piotr-binkowski/kintex-pcie-board/kintex-pcie.pdf

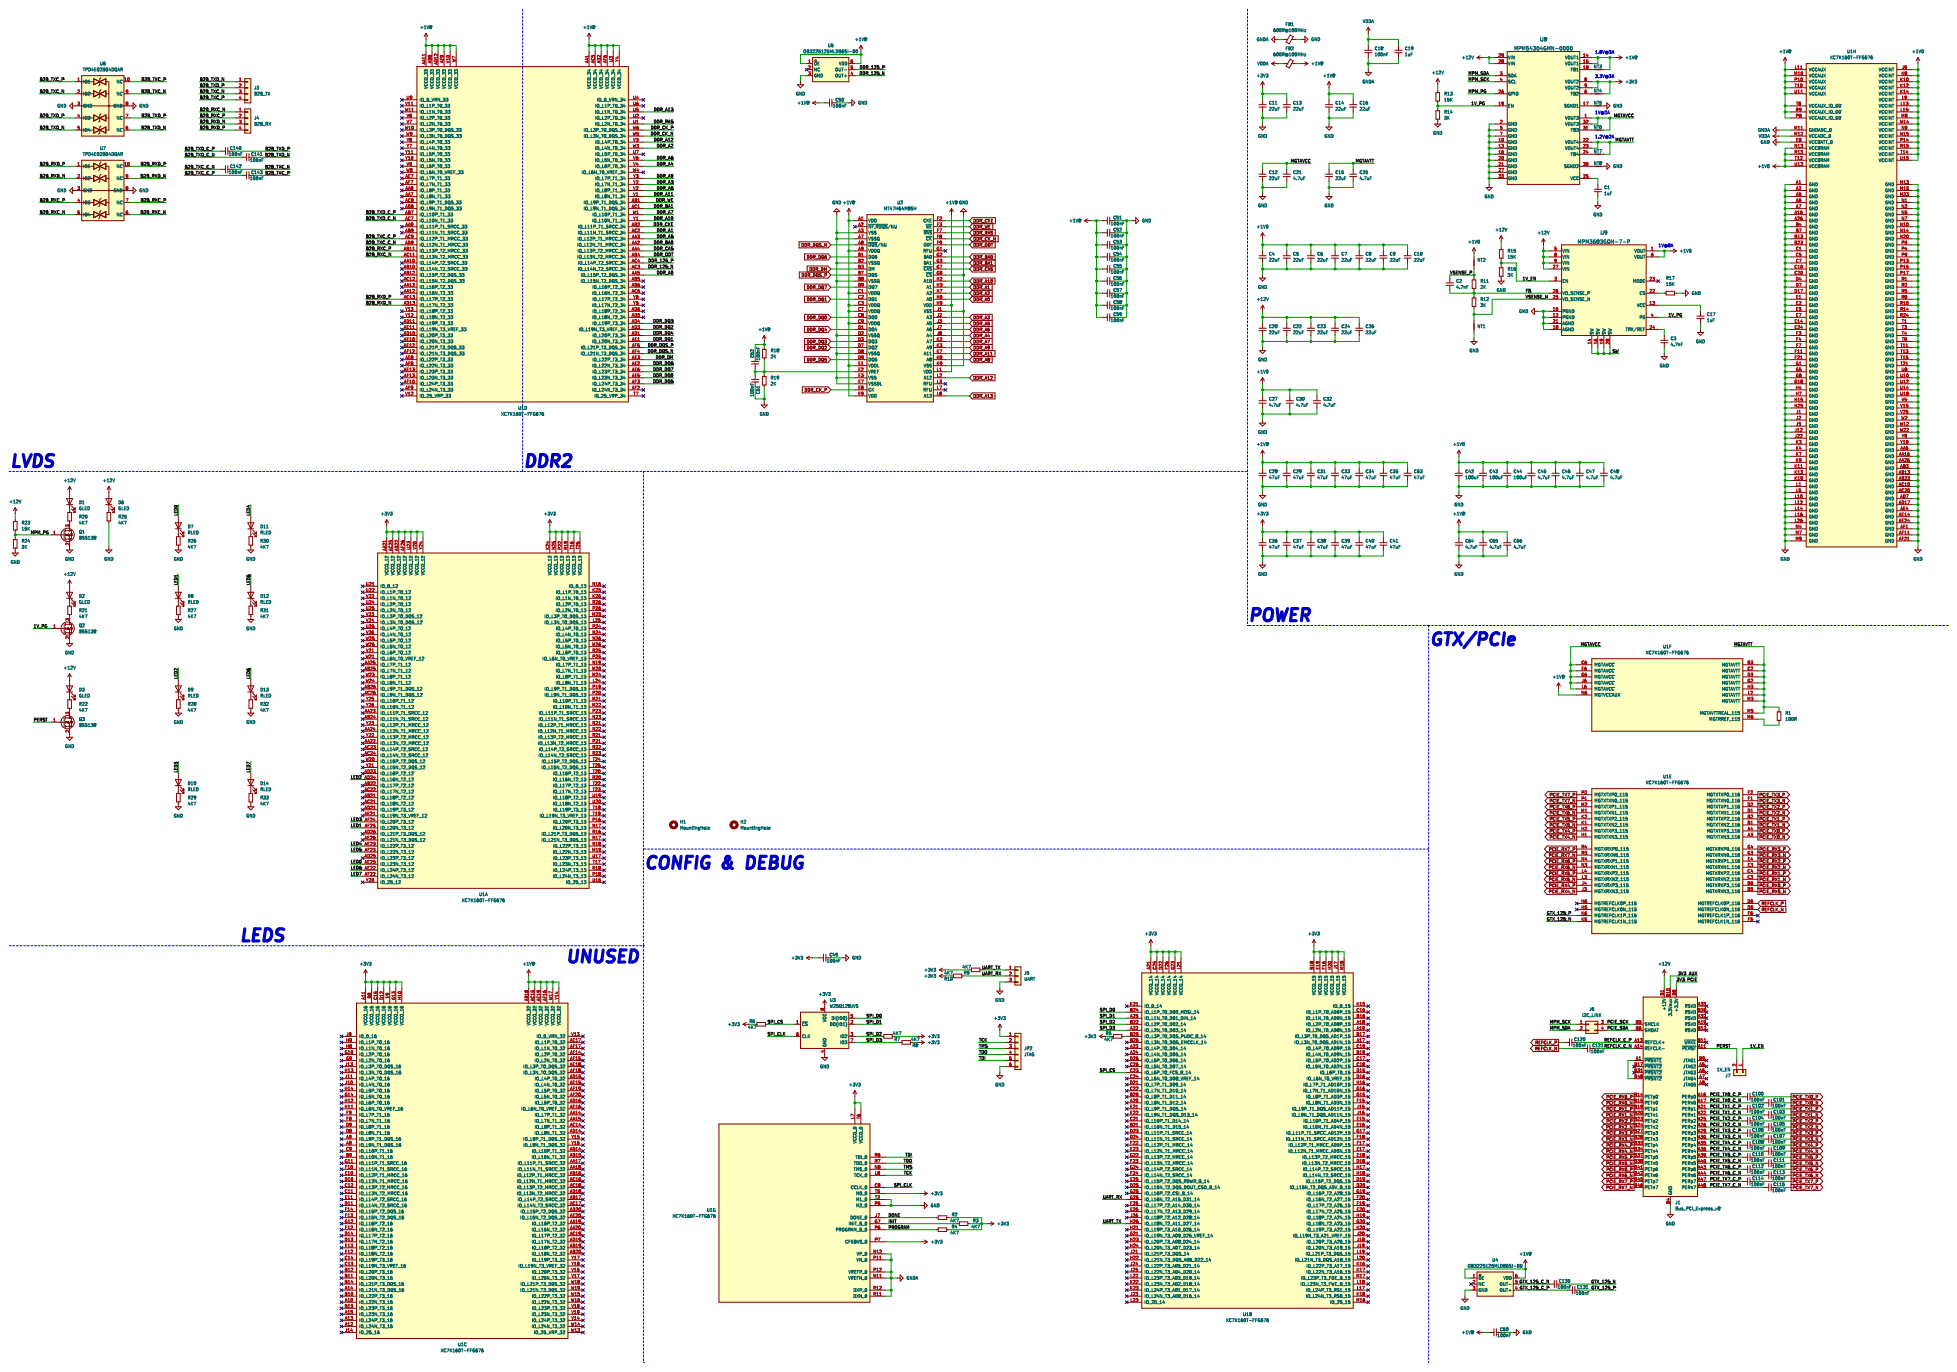
[picture p2: page 1]
