piotr-binkowski/kintex-pcie-board/kintex-pcie.kicad_sch

## KiCad design kintex-pcie.kicad_sch (2023-08-29)

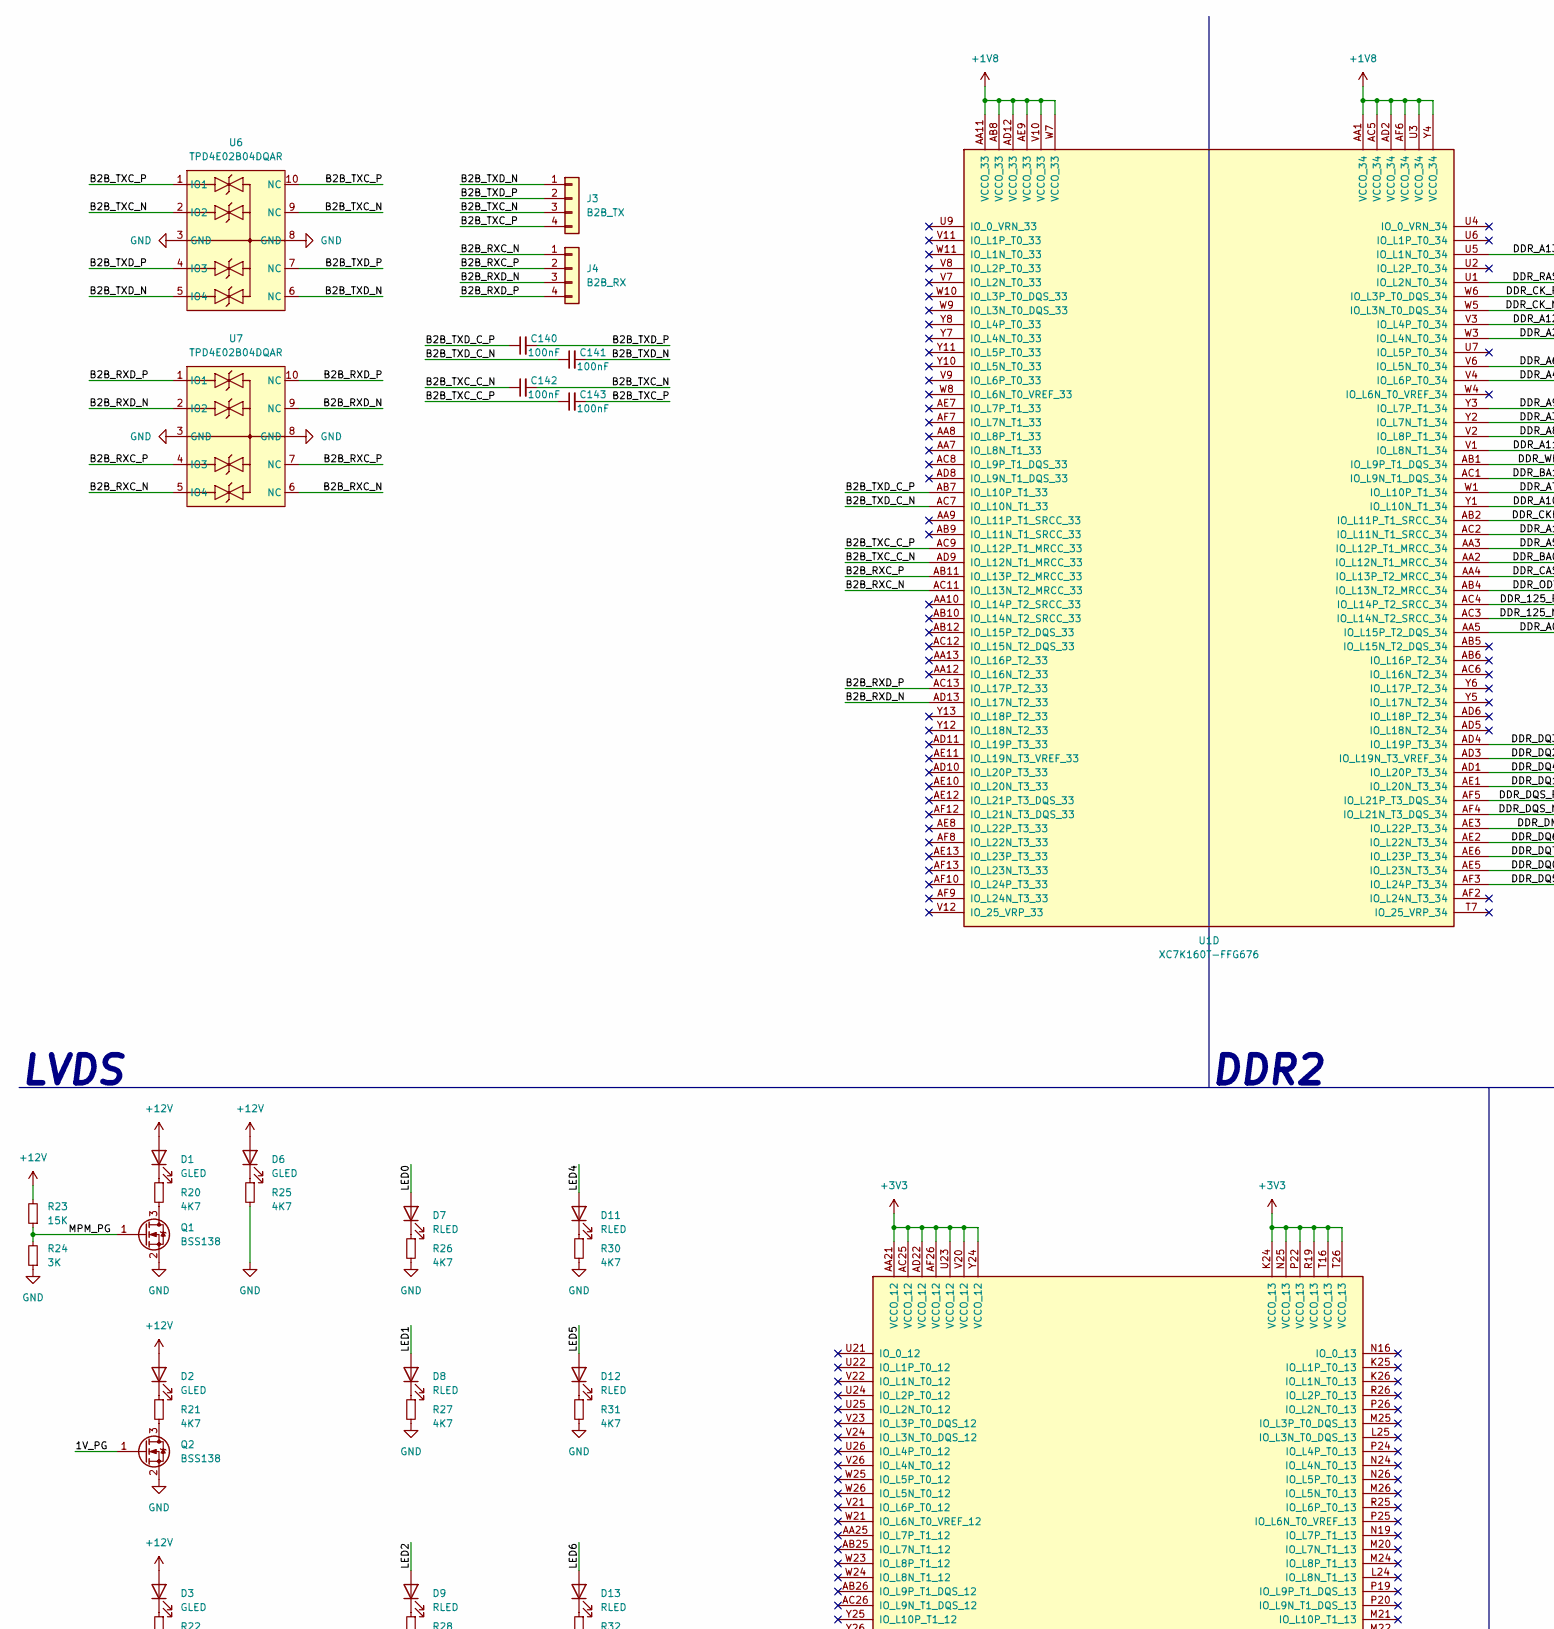
[picture p3: schematic kintex-pcie.kicad_sch, part in row 1, column 1]

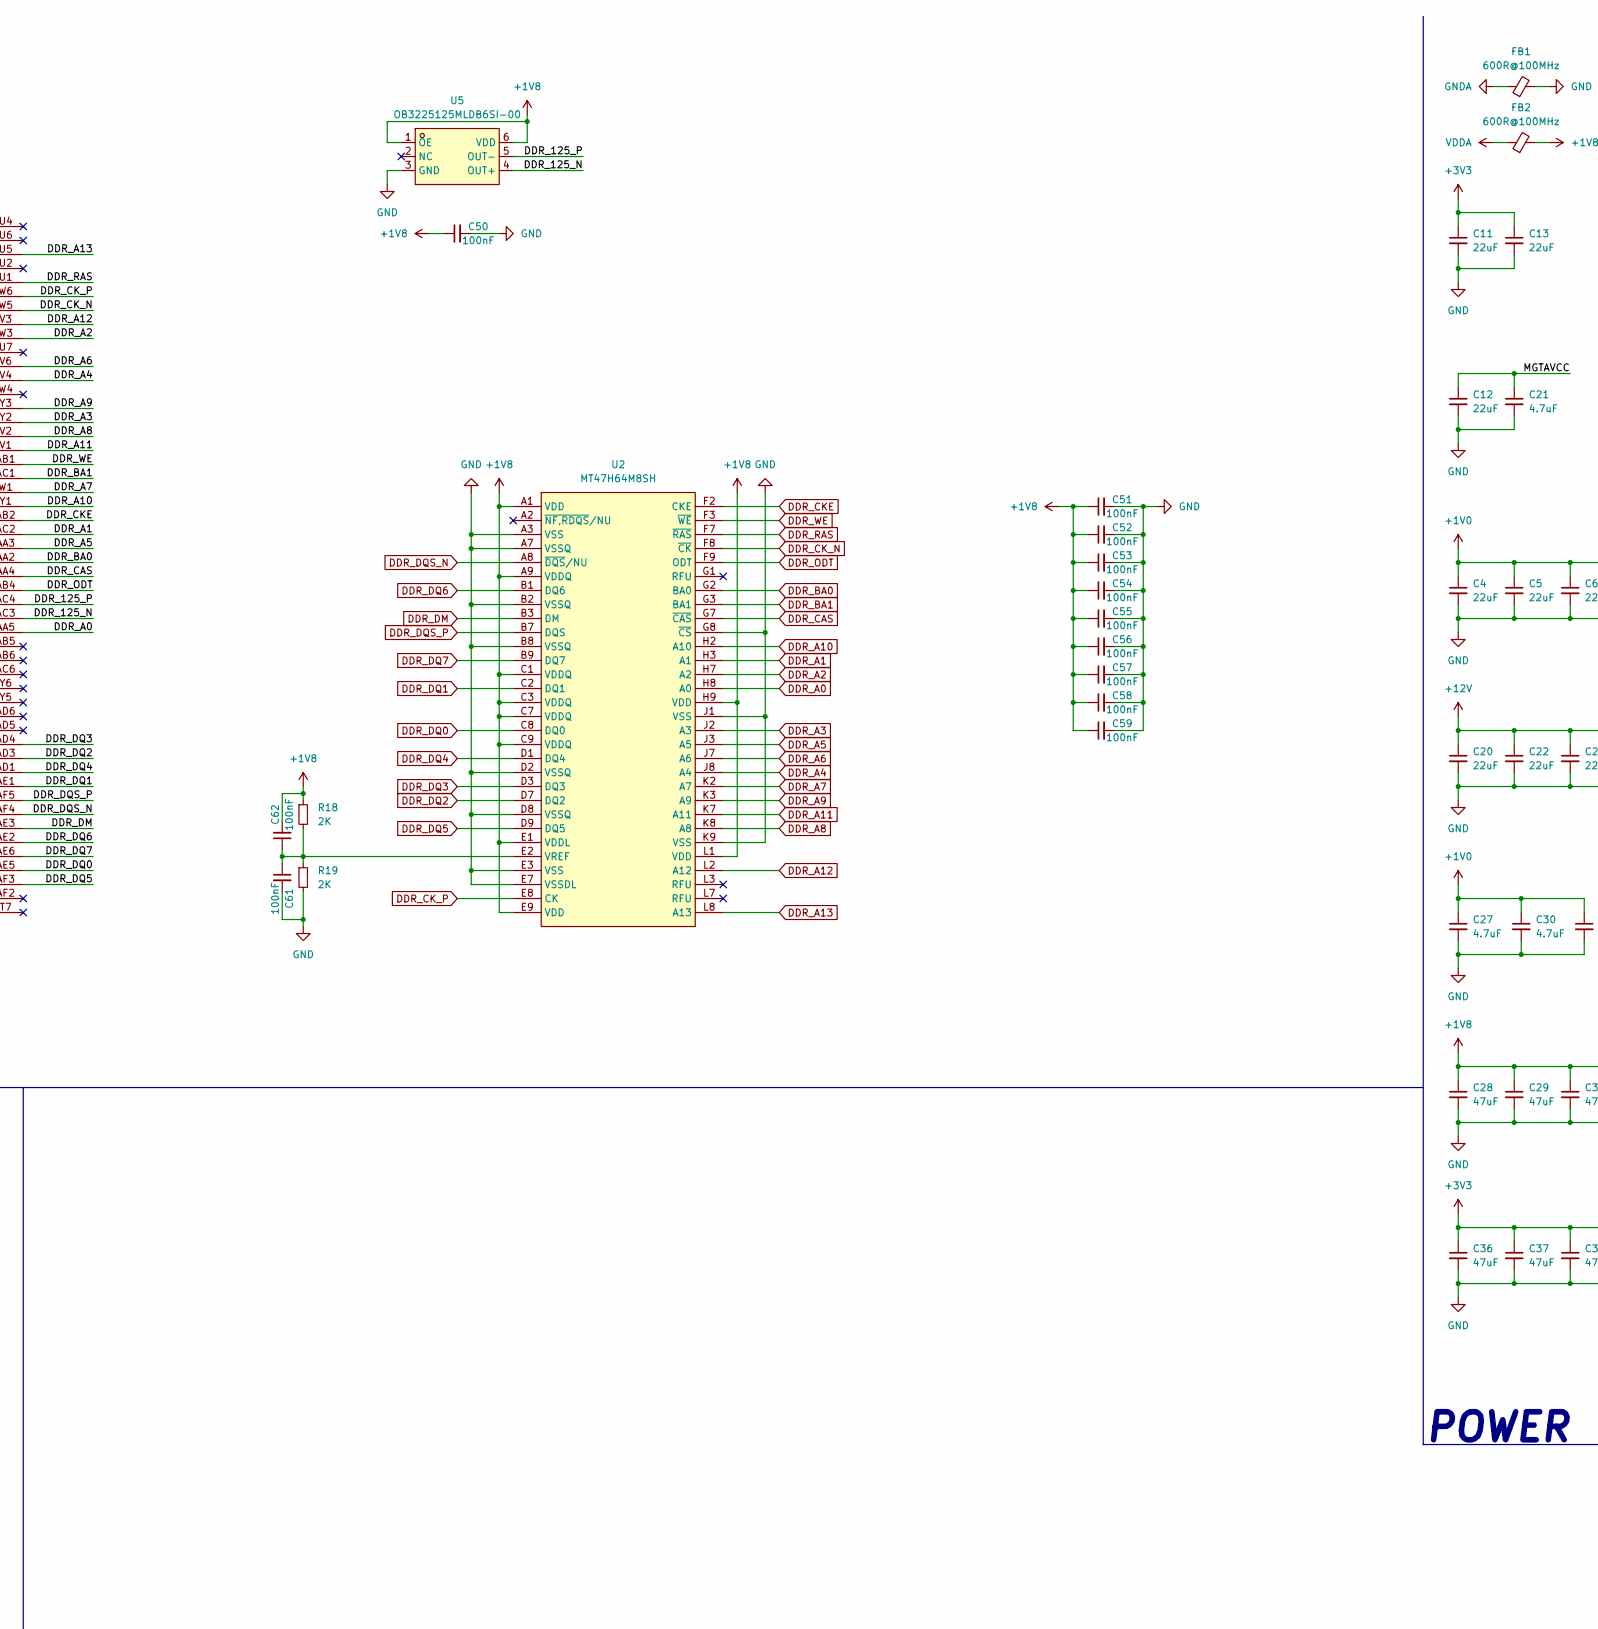
[picture p4: schematic kintex-pcie.kicad_sch, part in row 1, column 2]

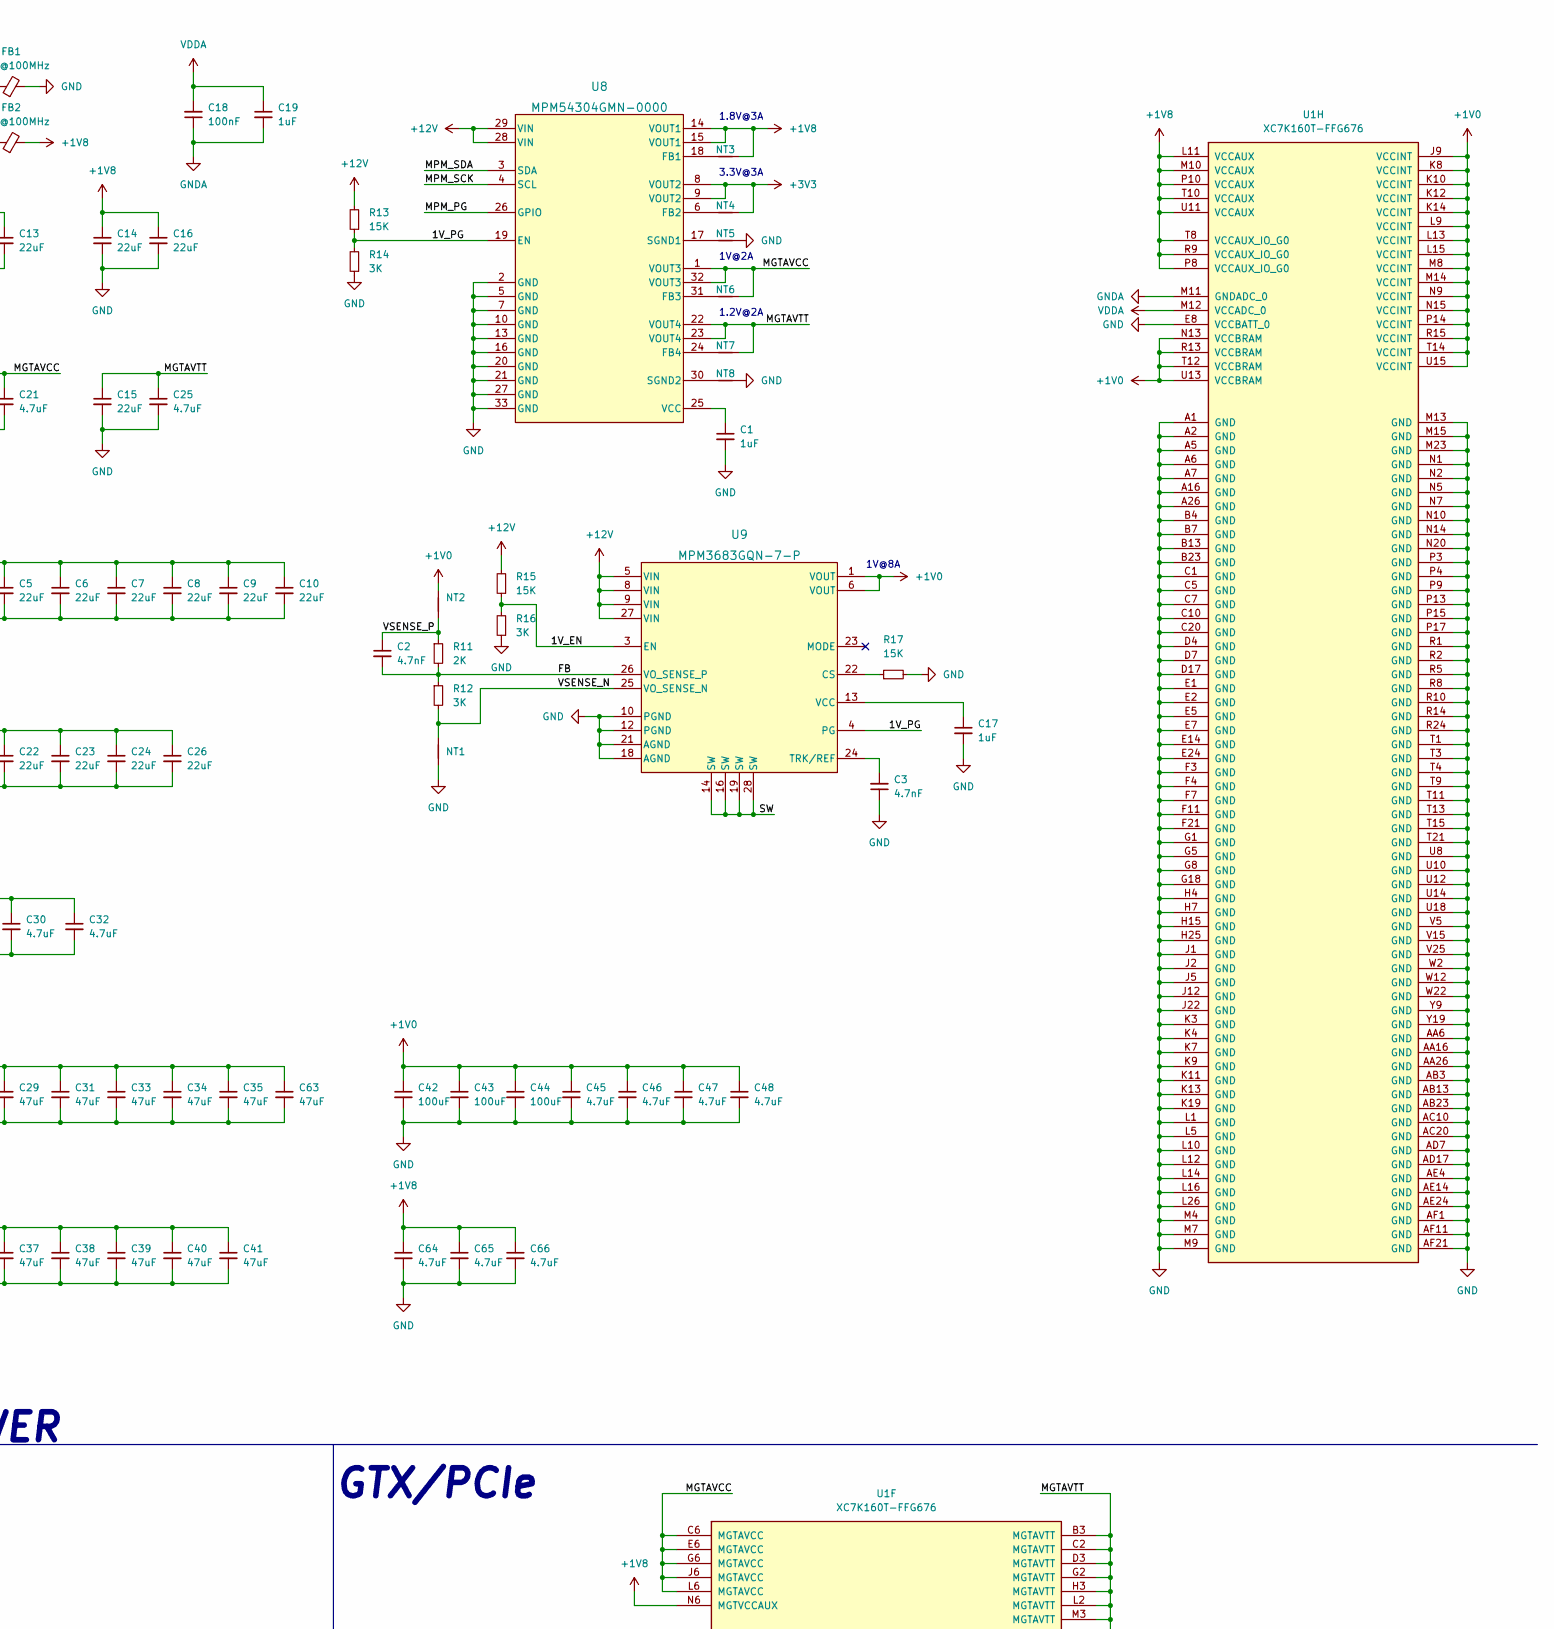
[picture p5: schematic kintex-pcie.kicad_sch, part in row 1, column 3]

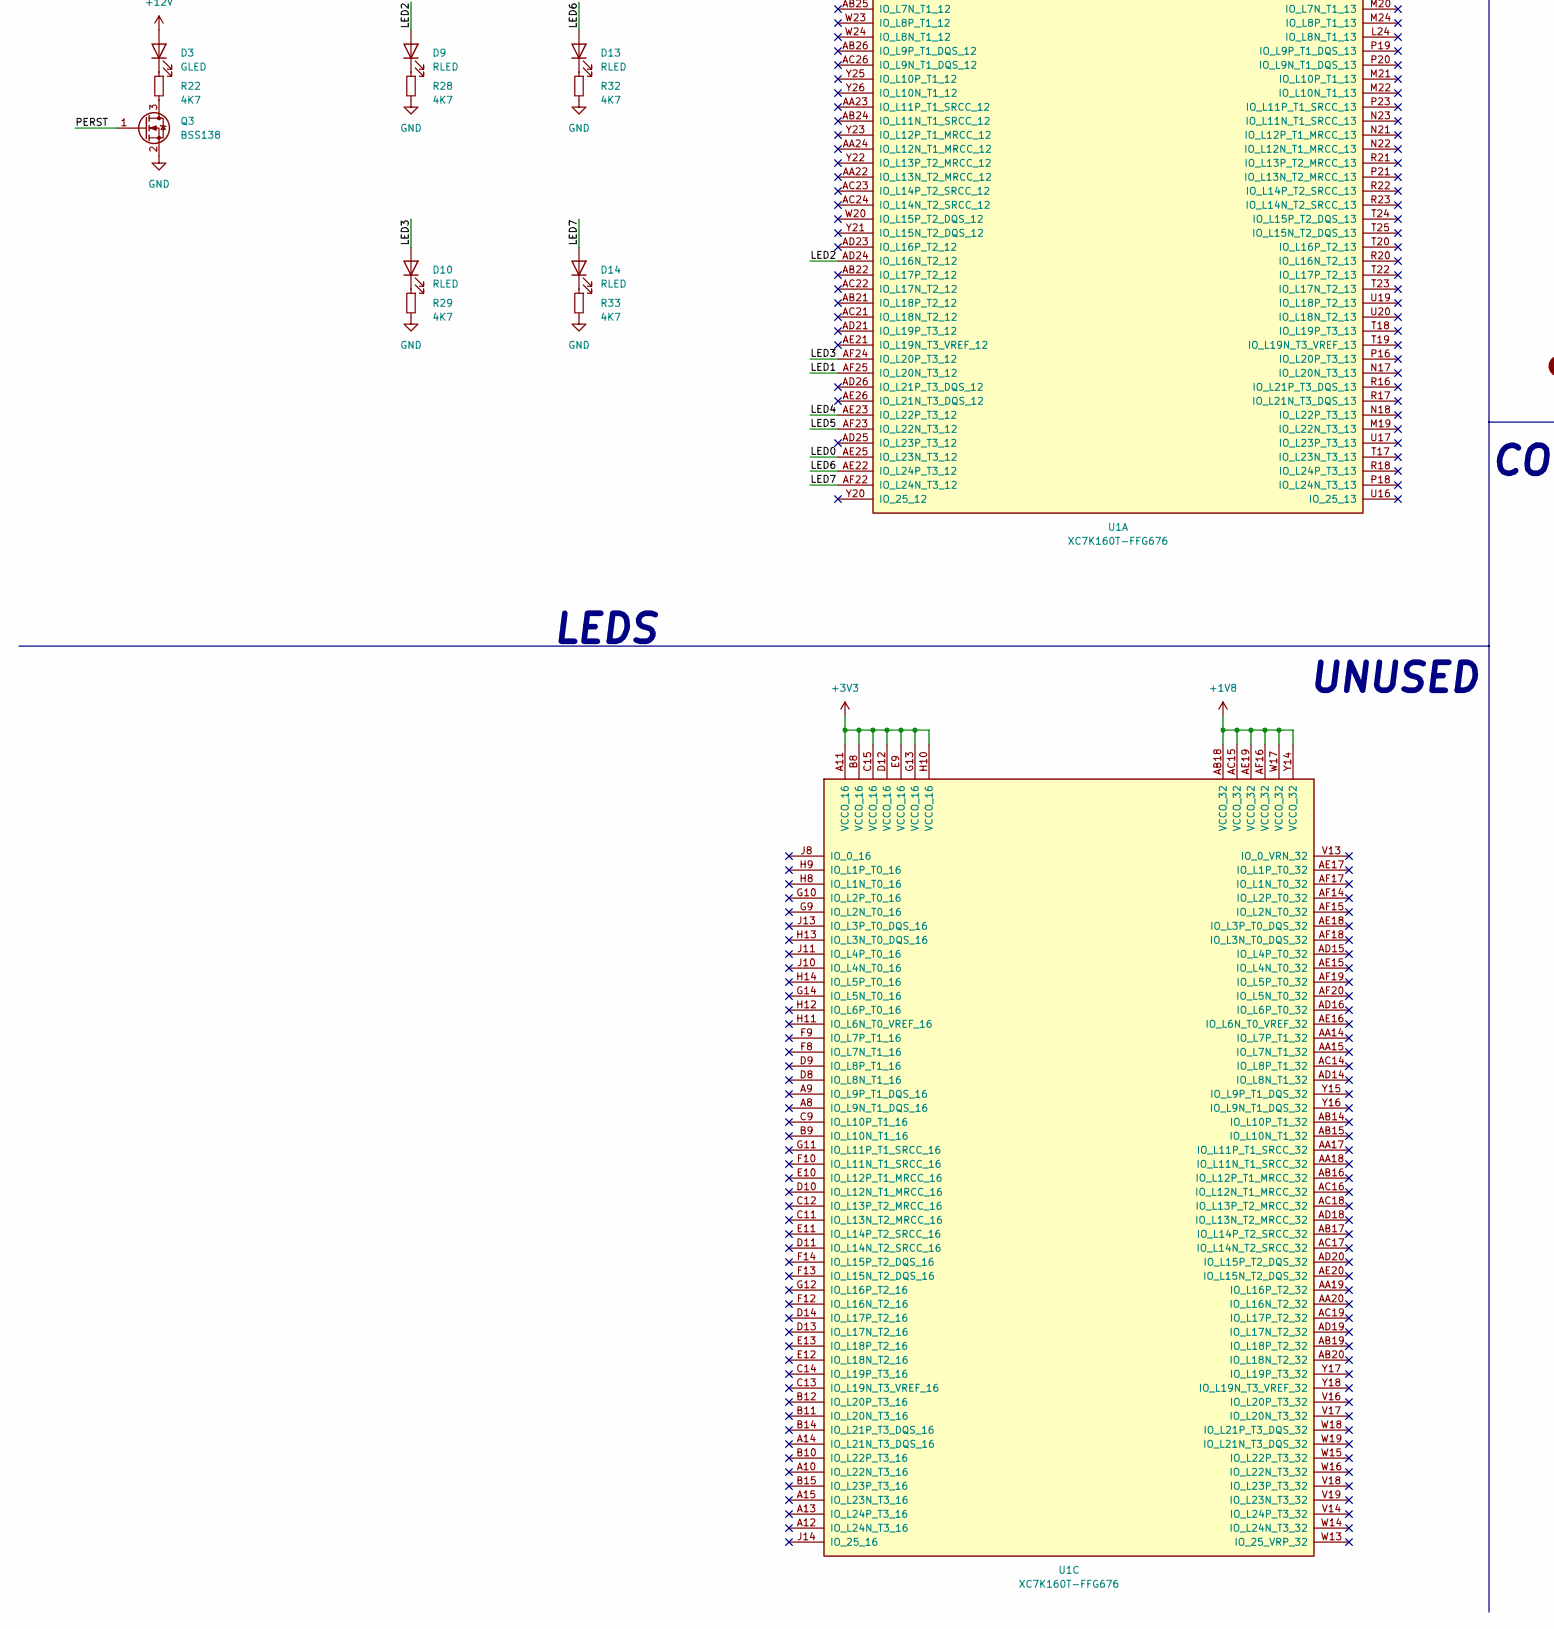
[picture p6: schematic kintex-pcie.kicad_sch, part in row 2, column 1]

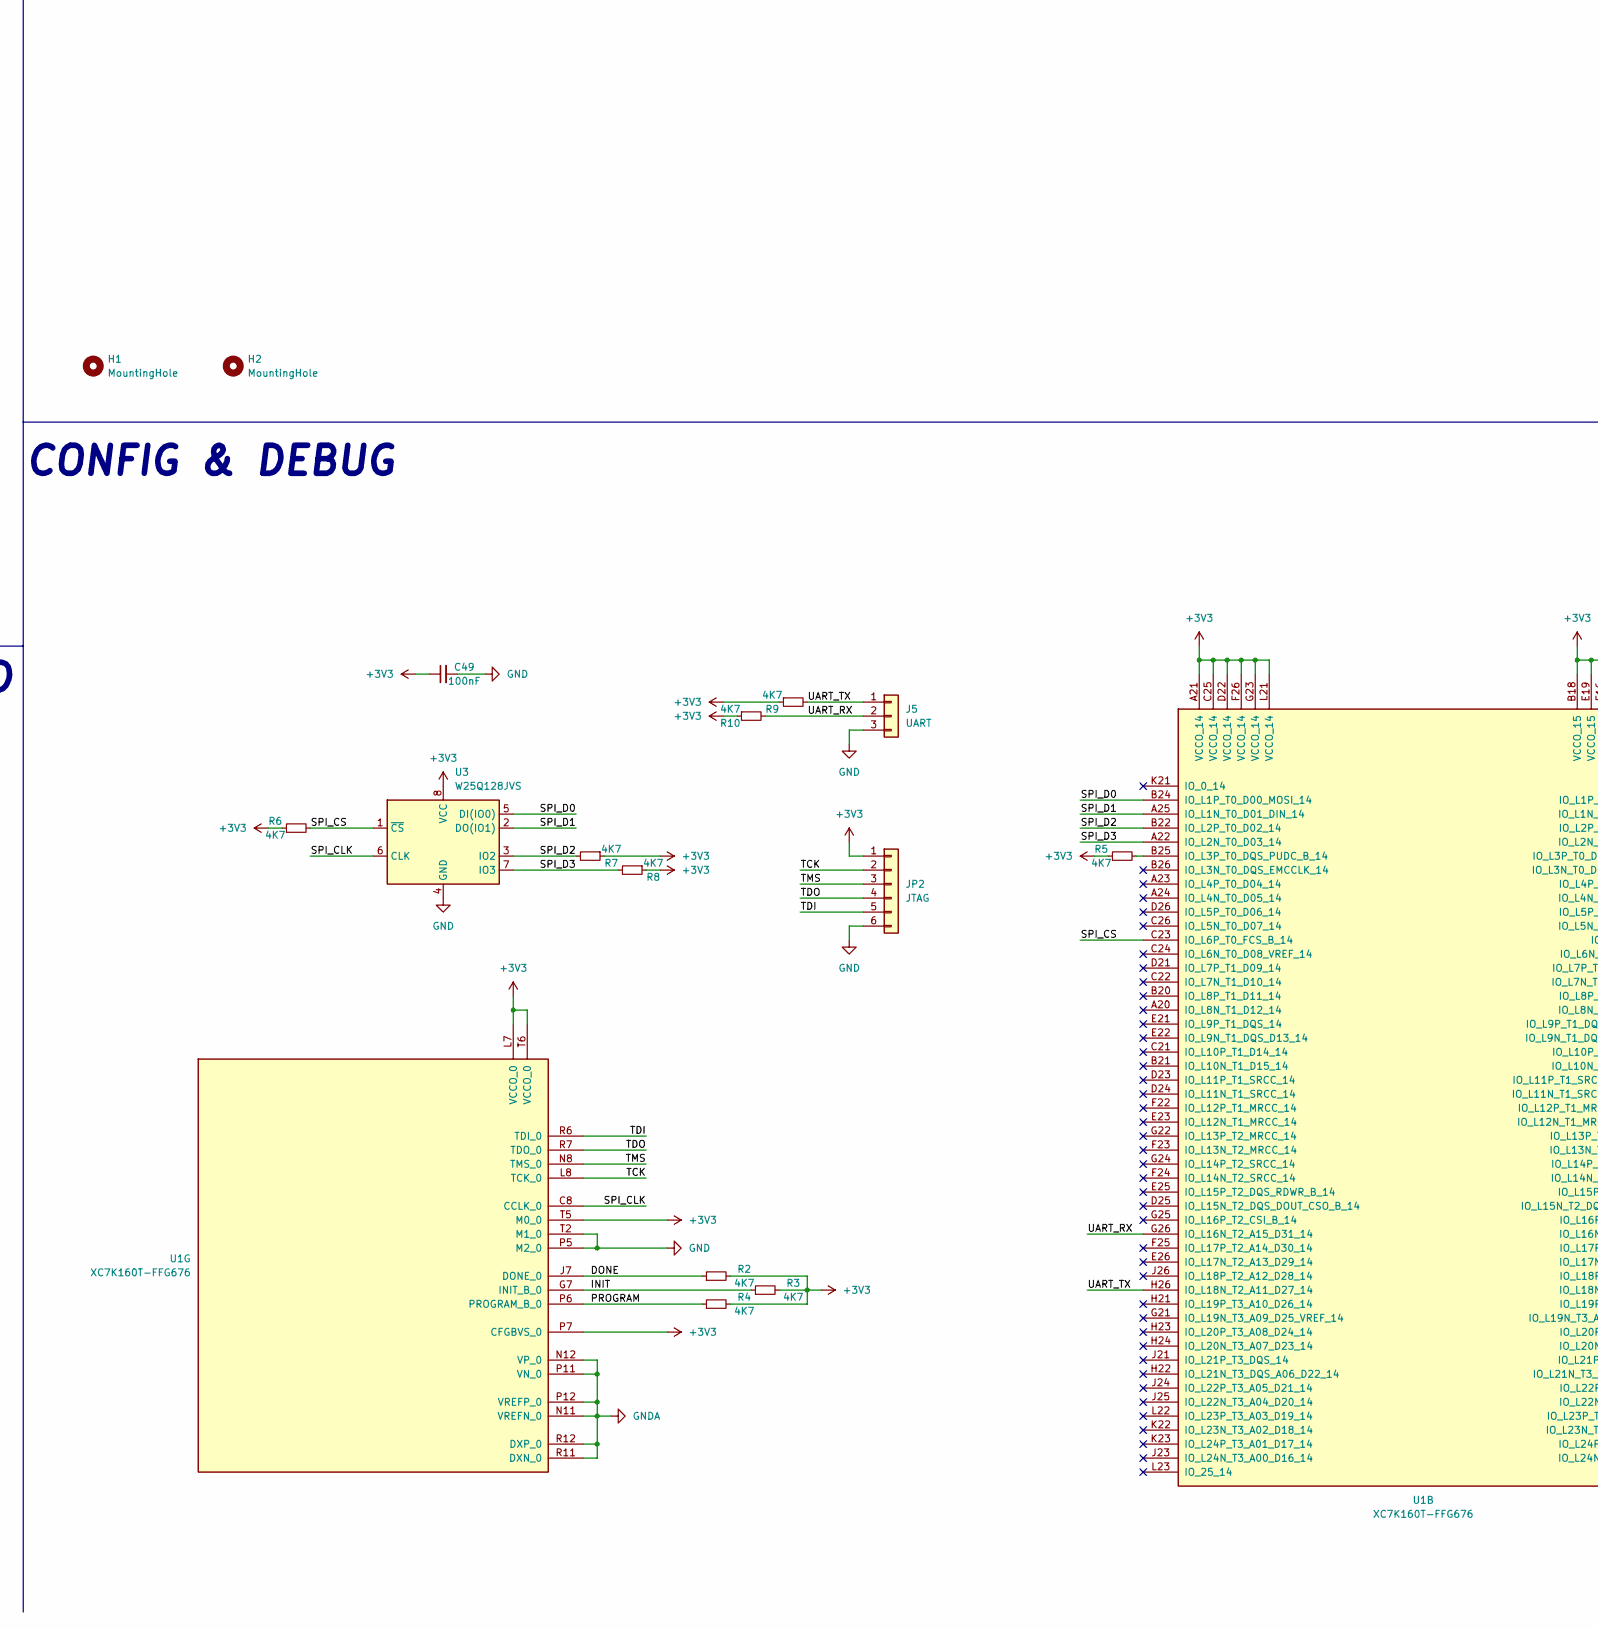
[picture p7: schematic kintex-pcie.kicad_sch, part in row 2, column 2]

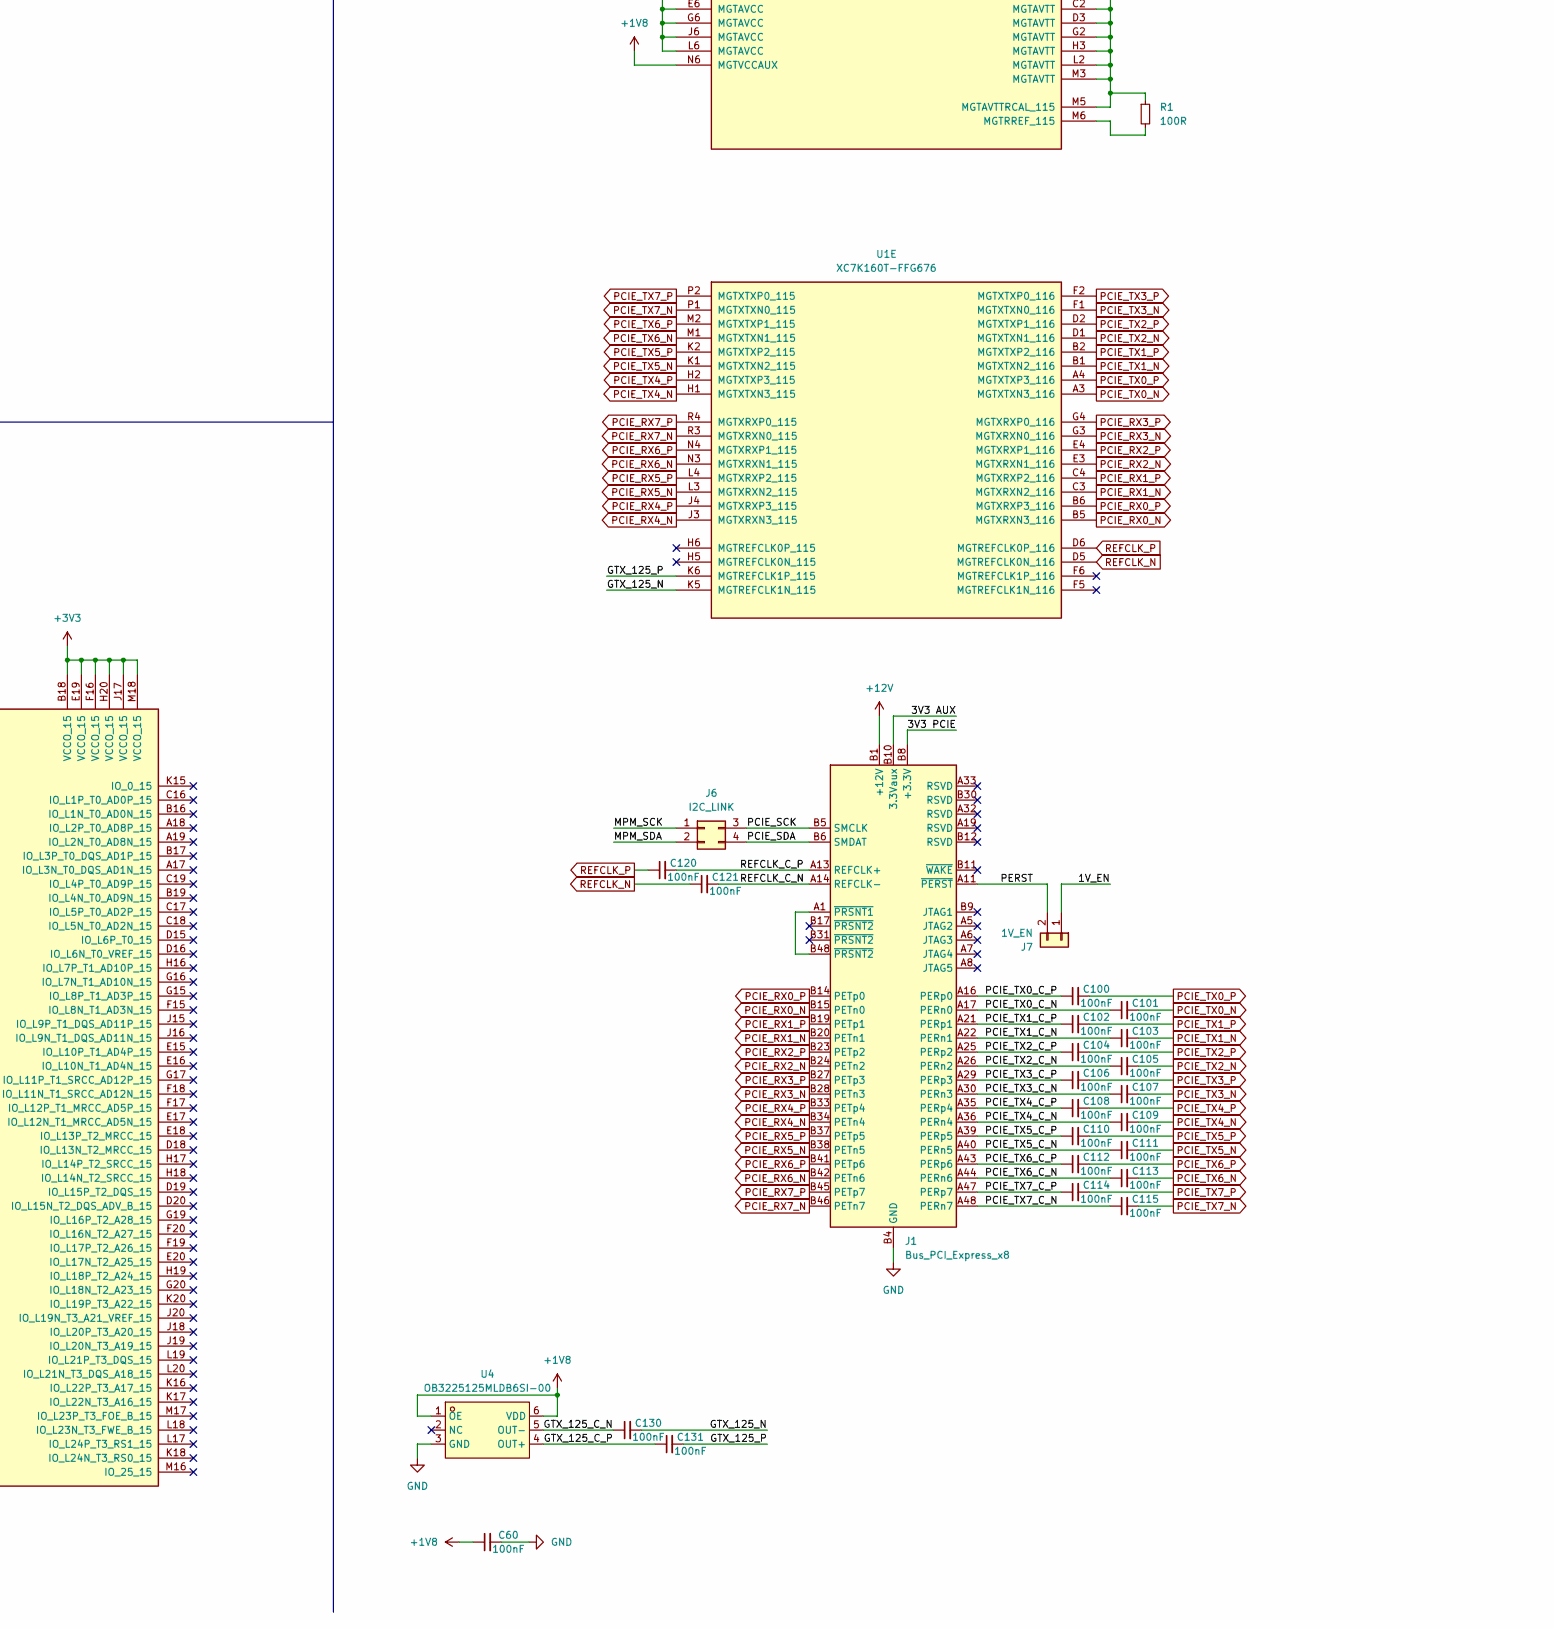
[picture p8: schematic kintex-pcie.kicad_sch, part in row 2, column 3]

Parts:
C1, C17, C19: 1uF; C_0402_1005Metric; LCSC C52923
C2, C3: 4.7nF; C_0402_1005Metric; LCSC C1538
C4, C5, C6, C7, C8, C9, C10, C11, C12, C13, C14, C15, C16, C20, C22, C23, C24, C26: 22uF; C_1206_3216Metric; LCSC C12891
C18, C49, C50, C51, C52, C53, C54, C55, C56, C57, C58, C59, C60, C61, C62, C100, C101, C102, C103, C104, C105, C106, C107, C108, C109, C110, C111, C112, C113, C114, C115, C120, C121, C130, C131, C140, C141, C142, C143: 100nF; C_0402_1005Metric; LCSC C1525
C21, C25, C27, C30, C32, C45, C46, C47, C48, C64, C65, C66: 4.7uF; C_0402_1005Metric; LCSC C23733
C28, C29, C31, C33, C34, C35, C36, C37, C38, C39, C40, C41, C63: 47uF; C_0805_2012Metric; LCSC C16780
C42, C43, C44: 100uF; C_1206_3216Metric; LCSC C15008
D1, D2, D3, D6: GLED; LED_0603_1608Metric; LCSC C72043
D7, D8, D9, D10, D11, D12, D13, D14: RLED; LED_0603_1608Metric; LCSC C2286
FB1, FB2: 600R@100MHz; R_0603_1608Metric; LCSC C1002
H1, H2: MountingHole; MountingHole_3.2mm_M3
J1: Bus_PCI_Express_x8; BUS_PCIexpress_x8
J3: B2B_TX; PinSocket_1x04_P2.54mm_Vertical
J4: B2B_RX; PinSocket_1x04_P2.54mm_Vertical
J5: UART; PinHeader_1x03_P2.54mm_Vertical
J6: I2C_LINK; PinHeader_2x02_P2.54mm_Vertical
J7: 1V_EN; PinHeader_1x02_P2.54mm_Vertical
JP2: JTAG; PinHeader_1x06_P2.54mm_Vertical
NT1, NT2, NT3, NT4, NT5, NT6, NT7, NT8: NetTie_2; NetTie-2_SMD_Pad0.5mm
Q1, Q2, Q3: BSS138; SOT-23; LCSC C2938375
R1: 100R; R_0402_1005Metric; LCSC C25076
R2, R3, R4, R5, R6, R7, R8, R9, R10, R20, R21, R22, R25, R26, R27, R28, R29, R30, R31, R32, R33: 4K7; R_0402_1005Metric; LCSC C25900
R11, R18, R19: 2K; R_0402_1005Metric; LCSC C4109
R12, R14, R16, R24: 3K; R_0402_1005Metric; LCSC C168223
R13, R15, R17, R23: 15K; R_0402_1005Metric; LCSC C25756
U1: XC7K160T-FFG676; Xilinx_FFG676; LCSC C966964
U2: MT47H64M8SH; FBGA-60_L10.0-W8.0-P0.80-TL_MICRON_MT47H64M8SH; LCSC C1353826
U3: W25Q128JVS; SOIC-8_5.23x5.23mm_P1.27mm; LCSC C97521
U4, U5: OB3225125MLDB6SI-00; OSC-SMD_6P-L3.2-W2.5-BL_SG3225EAN; LCSC C5173622
U6, U7: TPD4E02B04DQAR; USON-10_L2.5-W1.0-P0.50-BL; LCSC C106794
U8: MPM54304GMN-0000; LGA7x7x2_MNP; LCSC C9900053606
U9: MPM3683GQN-7-P; MPM3683GQN-7; LCSC C5252330

Connections:
1V_EN: J7.1, R15.1, R16.2, U9.3 (EN)
1V_PG: Q2.1 (G), R13.1, R14.2, U8.19 (EN), U9.4 (PG)
3V3 AUX: J1.B10 (3.3Vaux)
3V3 PCIE: J1.A9 (+3.3V), J1.A10 (+3.3V), J1.B8 (+3.3V)
+1V0: C4.1, C5.1, C6.1, C7.1, C8.1, C9.1, C10.1, C27.1, C30.1, C32.1, C42.1, C43.1, C44.1, C45.1, C46.1, C47.1, C48.1, NT2.2, U1.J9 (VCCINT), U1.K8 (VCCINT), U1.K10 (VCCINT), U1.K12 (VCCINT), U1.K14 (VCCINT), U1.L9 (VCCINT), U1.L13 (VCCINT), U1.L15 (VCCINT), U1.M8 (VCCINT), U1.M14 (VCCINT), U1.N9 (VCCINT), U1.N13 (VCCBRAM), U1.N15 (VCCINT), U1.P14 (VCCINT), U1.R13 (VCCBRAM), U1.R15 (VCCINT), U1.T12 (VCCBRAM), U1.T14 (VCCINT), U1.U13 (VCCBRAM), U1.U15 (VCCINT), U9.1 (VOUT), U9.6 (VOUT)
+1V8: C14.1, C16.1, C28.1, C29.1, C31.1, C33.1, C34.1, C35.1, C50.1, C51.1, C52.1, C53.1, C54.1, C55.1, C56.1, C57.1, C58.1, C59.1, C60.1, C62.2, C63.1, C64.1, C65.1, C66.1, FB2.2, NT3.2, R18.1, U1.AA1 (VCCO_34), U1.AA11 (VCCO_33), U1.AB8 (VCCO_33), U1.AB18 (VCCO_32), U1.AC5 (VCCO_34), U1.AC15 (VCCO_32), U1.AD2 (VCCO_34), U1.AD12 (VCCO_33), U1.AE9 (VCCO_33), U1.AE19 (VCCO_32), U1.AF6 (VCCO_34), U1.AF16 (VCCO_32), U1.L11 (VCCAUX), U1.M10 (VCCAUX), U1.N6 (MGTVCCAUX), U1.P8 (VCCAUX_IO_G0), U1.P10 (VCCAUX), U1.R9 (VCCAUX_IO_G0), U1.T8 (VCCAUX_IO_G0), U1.T10 (VCCAUX), U1.U3 (VCCO_34), U1.U11 (VCCAUX), U1.V10 (VCCO_33), U1.W7 (VCCO_33), U1.W17 (VCCO_32), U1.Y4 (VCCO_34), U1.Y14 (VCCO_32), U2.A1 (VDD), U2.A9 (VDDQ), U2.C1 (VDDQ), U2.C3 (VDDQ), U2.C7 (VDDQ), U2.C9 (VDDQ), U2.E1 (VDDL), U2.E9 (VDD), U2.H9 (VDD), U2.L1 (VDD), U4.1 (OE), U4.6 (VDD), U5.1 (OE), U5.6 (VDD), U8.14 (VOUT1), U8.15 (VOUT1)
+3V3: C11.1, C13.1, C36.1, C37.1, C38.1, C39.1, C40.1, C41.1, C49.1, JP2.1, NT4.2, R2.2, R3.2, R4.2, R5.1, R6.1, R7.1, R8.1, R9.1, R10.1, U1.A11 (VCCO_16), U1.A21 (VCCO_14), U1.AA21 (VCCO_12), U1.AC25 (VCCO_12), U1.AD22 (VCCO_12), U1.AF26 (VCCO_12), U1.B8 (VCCO_16), U1.B18 (VCCO_15), U1.C15 (VCCO_16), U1.C25 (VCCO_14), U1.D12 (VCCO_16), U1.D22 (VCCO_14), U1.E9 (VCCO_16), U1.E19 (VCCO_15), U1.F16 (VCCO_15), U1.F26 (VCCO_14), U1.G13 (VCCO_16), U1.G23 (VCCO_14), U1.H10 (VCCO_16), U1.H20 (VCCO_15), U1.J17 (VCCO_15), U1.K24 (VCCO_13), U1.L7 (VCCO_0), U1.L21 (VCCO_14), U1.M18 (VCCO_15), U1.N25 (VCCO_13), U1.P7 (CFGBVS_0), U1.P22 (VCCO_13), U1.R19 (VCCO_13), U1.T5 (M0_0), U1.T6 (VCCO_0), U1.T16 (VCCO_13), U1.T26 (VCCO_13), U1.U23 (VCCO_12), U1.V20 (VCCO_12), U1.Y24 (VCCO_12), U3.8 (VCC), U8.8 (VOUT2), U8.9 (VOUT2)
+12V: C20.1, C22.1, C23.1, C24.1, C26.1, D1.2 (A), D2.2 (A), D3.2 (A), D6.2 (A), J1.A2 (+12V), J1.A3 (+12V), J1.B1 (+12V), J1.B2 (+12V), J1.B3 (+12V), R13.2, R15.2, R23.2, U8.28 (VIN), U8.29 (VIN), U9.5 (VIN), U9.8 (VIN), U9.9 (VIN), U9.27 (VIN)
B2B_RXC_N: J4.1, U1.AC11 (IO_L13N_T2_MRCC_33), U7.5 (IO4), U7.6 (NC)
B2B_RXC_P: J4.2, U1.AB11 (IO_L13P_T2_MRCC_33), U7.4 (IO3), U7.7 (NC)
B2B_RXD_N: J4.3, U1.AD13 (IO_L17N_T2_33), U7.2 (IO2), U7.9 (NC)
B2B_RXD_P: J4.4, U1.AC13 (IO_L17P_T2_33), U7.1 (IO1), U7.10 (NC)
B2B_TXC_C_N: C142.1, U1.AD9 (IO_L12N_T1_MRCC_33)
B2B_TXC_C_P: C143.1, U1.AC9 (IO_L12P_T1_MRCC_33)
B2B_TXC_N: C142.2, J3.3, U6.2 (IO2), U6.9 (NC)
B2B_TXC_P: C143.2, J3.4, U6.1 (IO1), U6.10 (NC)
B2B_TXD_C_N: C141.1, U1.AC7 (IO_L10N_T1_33)
B2B_TXD_C_P: C140.1, U1.AB7 (IO_L10P_T1_33)
B2B_TXD_N: C141.2, J3.1, U6.5 (IO4), U6.6 (NC)
B2B_TXD_P: C140.2, J3.2, U6.4 (IO3), U6.7 (NC)
DDR_125_N: U1.AC3 (IO_L14N_T2_SRCC_34), U5.4 (OUT+)
DDR_125_P: U1.AC4 (IO_L14P_T2_SRCC_34), U5.5 (OUT-)
DDR_A0: U1.AA5 (IO_L15P_T2_DQS_34), U2.H8 (A0)
DDR_A1: U1.AC2 (IO_L11N_T1_SRCC_34), U2.H3 (A1)
DDR_A2: U1.W3 (IO_L4N_T0_34), U2.H7 (A2)
DDR_A3: U1.Y2 (IO_L7N_T1_34), U2.J2 (A3)
DDR_A4: U1.V4 (IO_L6P_T0_34), U2.J8 (A4)
DDR_A5: U1.AA3 (IO_L12P_T1_MRCC_34), U2.J3 (A5)
DDR_A6: U1.V6 (IO_L5N_T0_34), U2.J7 (A6)
DDR_A7: U1.W1 (IO_L10P_T1_34), U2.K2 (A7)
DDR_A8: U1.V2 (IO_L8P_T1_34), U2.K8 (A8)
DDR_A9: U1.Y3 (IO_L7P_T1_34), U2.K3 (A9)
DDR_A10: U1.Y1 (IO_L10N_T1_34), U2.H2 (A10)
DDR_A11: U1.V1 (IO_L8N_T1_34), U2.K7 (A11)
DDR_A12: U1.V3 (IO_L4P_T0_34), U2.L2 (A12)
DDR_A13: U1.U5 (IO_L1N_T0_34), U2.L8 (A13)
DDR_BA0: U1.AA2 (IO_L12N_T1_MRCC_34), U2.G2 (BA0)
DDR_BA1: U1.AC1 (IO_L9N_T1_DQS_34), U2.G3 (BA1)
DDR_CAS: U1.AA4 (IO_L13P_T2_MRCC_34), U2.G7 (~CAS)
DDR_CKE: U1.AB2 (IO_L11P_T1_SRCC_34), U2.F2 (CKE)
DDR_CK_N: U1.W5 (IO_L3N_T0_DQS_34), U2.F8 (~CK)
DDR_CK_P: U1.W6 (IO_L3P_T0_DQS_34), U2.E8 (CK)
DDR_DM: U1.AE3 (IO_L22P_T3_34), U2.B3 (DM)
DDR_DQ0: U1.AE5 (IO_L23N_T3_34), U2.C8 (DQ0)
DDR_DQ1: U1.AE1 (IO_L20N_T3_34), U2.C2 (DQ1)
DDR_DQ2: U1.AD3 (IO_L19N_T3_VREF_34), U2.D7 (DQ2)
DDR_DQ3: U1.AD4 (IO_L19P_T3_34), U2.D3 (DQ3)
DDR_DQ4: U1.AD1 (IO_L20P_T3_34), U2.D1 (DQ4)
DDR_DQ5: U1.AF3 (IO_L24P_T3_34), U2.D9 (DQ5)
DDR_DQ6: U1.AE2 (IO_L22N_T3_34), U2.B1 (DQ6)
DDR_DQ7: U1.AE6 (IO_L23P_T3_34), U2.B9 (DQ7)
DDR_DQS_N: U1.AF4 (IO_L21N_T3_DQS_34), U2.A8 (~DQS/NU)
DDR_DQS_P: U1.AF5 (IO_L21P_T3_DQS_34), U2.B7 (DQS)
DDR_ODT: U1.AB4 (IO_L13N_T2_MRCC_34), U2.F9 (ODT)
DDR_RAS: U1.U1 (IO_L2N_T0_34), U2.F7 (~RAS)
DDR_WE: U1.AB1 (IO_L9P_T1_DQS_34), U2.F3 (~WE)
DONE: R2.1, U1.J7 (DONE_0)
FB: C2.2, R11.2, R12.1, U9.26 (VO_SENSE_P)
GND: C1.2, C3.1, C4.2, C5.2, C6.2, C7.2, C8.2, C9.2, C10.2, C11.2, C12.2, C13.2, C14.2, C15.2, C16.2, C17.2, C20.2, C21.2, C22.2, C23.2, C24.2, C25.2, C26.2, C27.2, C28.2, C29.2, C30.2, C31.2, C32.2, C33.2, C34.2, C35.2, C36.2, C37.2, C38.2, C39.2, C40.2, C41.2, C42.2, C43.2, C44.2, C45.2, C46.2, C47.2, C48.2, C49.2, C50.2, C51.2, C52.2, C53.2, C54.2, C55.2, C56.2, C57.2, C58.2, C59.2, C60.2, C61.2, C63.2, C64.2, C65.2, C66.2, FB1.2, J1.A4 (GND), J1.A12 (GND), J1.A15 (GND), J1.A18 (GND), J1.A20 (GND), J1.A23 (GND), J1.A24 (GND), J1.A27 (GND), J1.A28 (GND), J1.A31 (GND), J1.A34 (GND), J1.A37 (GND), J1.A38 (GND), J1.A41 (GND), J1.A42 (GND), J1.A45 (GND), J1.A46 (GND), J1.A49 (GND), J1.B4 (GND), J1.B7 (GND), J1.B13 (GND), J1.B16 (GND), J1.B18 (GND), J1.B21 (GND), J1.B22 (GND), J1.B25 (GND), J1.B26 (GND), J1.B29 (GND), J1.B32 (GND), J1.B35 (GND), J1.B36 (GND), J1.B39 (GND), J1.B40 (GND), J1.B43 (GND), J1.B44 (GND), J1.B47 (GND), J1.B49 (GND), J5.3, JP2.6, NT1.1, NT5.2, NT8.2, Q1.2 (S), Q2.2 (S), Q3.2 (S), R14.1, R16.1, R17.2, R19.2, R24.1, R25.2, R26.2, R27.2, R28.2, R29.2, R30.2, R31.2, R32.2, R33.2, U1.A1 (GND), U1.A2 (GND), U1.A5 (GND), U1.A6 (GND), U1.A7 (GND), U1.A16 (GND), U1.A26 (GND), U1.AA6 (GND), U1.AA16 (GND), U1.AA26 (GND), U1.AB3 (GND), U1.AB13 (GND), U1.AB23 (GND), U1.AC10 (GND), U1.AC20 (GND), U1.AD7 (GND), U1.AD17 (GND), U1.AE4 (GND), U1.AE14 (GND), U1.AE24 (GND), U1.AF1 (GND), U1.AF11 (GND), U1.AF21 (GND), U1.B4 (GND), U1.B7 (GND), U1.B13 (GND), U1.B23 (GND), U1.C1 (GND), U1.C5 (GND), U1.C7 (GND), U1.C10 (GND), U1.C20 (GND), U1.D4 (GND), U1.D7 (GND), U1.D17 (GND), U1.E1 (GND), U1.E2 (GND), U1.E5 (GND), U1.E7 (GND), U1.E8 (VCCBATT_0), U1.E14 (GND), U1.E24 (GND), U1.F3 (GND), U1.F4 (GND), U1.F7 (GND), U1.F11 (GND), U1.F21 (GND), U1.G1 (GND), U1.G5 (GND), U1.G8 (GND), U1.G18 (GND), U1.H4 (GND), U1.H7 (GND), U1.H15 (GND), U1.H25 (GND), U1.J1 (GND), U1.J2 (GND), U1.J5 (GND), U1.J12 (GND), U1.J22 (GND), U1.K3 (GND), U1.K4 (GND), U1.K7 (GND), U1.K9 (GND), U1.K11 (GND), U1.K13 (GND), U1.K19 (GND), U1.L1 (GND), U1.L5 (GND), U1.L10 (GND), U1.L12 (GND), U1.L14 (GND), U1.L16 (GND), U1.L26 (GND), U1.M4 (GND), U1.M7 (GND), U1.M9 (GND), U1.M13 (GND), U1.M15 (GND), U1.M23 (GND), U1.N1 (GND), U1.N2 (GND), U1.N5 (GND), U1.N7 (GND), U1.N10 (GND), U1.N14 (GND), U1.N20 (GND), U1.P3 (GND), U1.P4 (GND), U1.P5 (M2_0), U1.P9 (GND), U1.P13 (GND), U1.P15 (GND), U1.P17 (GND), U1.R1 (GND), U1.R2 (GND), U1.R5 (GND), U1.R8 (GND), U1.R10 (GND), U1.R14 (GND), U1.R24 (GND), U1.T1 (GND), U1.T2 (M1_0), U1.T3 (GND), U1.T4 (GND), U1.T9 (GND), U1.T11 (GND), U1.T13 (GND), U1.T15 (GND), U1.T21 (GND), U1.U8 (GND), U1.U10 (GND), U1.U12 (GND), U1.U14 (GND), U1.U18 (GND), U1.V5 (GND), U1.V15 (GND), U1.V25 (GND), U1.W2 (GND), U1.W12 (GND), U1.W22 (GND), U1.Y9 (GND), U1.Y19 (GND), U2.A3 (VSS), U2.A7 (VSSQ), U2.B2 (VSSQ), U2.B8 (VSSQ), U2.D2 (VSSQ), U2.D8 (VSSQ), U2.E3 (VSS), U2.E7 (VSSDL), U2.G8 (~CS), U2.J1 (VSS), U2.K9 (VSS), U3.4 (GND), U4.3 (GND), U5.3 (GND), U6.3 (GND), U6.8 (GND), U7.3 (GND), U7.8 (GND), U8.2 (GND), U8.5 (GND), U8.7 (GND), U8.10 (GND), U8.13 (GND), U8.16 (GND), U8.20 (GND), U8.21 (GND), U8.27 (GND), U8.33 (GND), U9.10 (PGND), U9.12 (PGND), U9.18 (AGND), U9.21 (AGND)
GNDA: C18.1, C19.2, FB1.1, U1.M11 (GNDADC_0), U1.N11 (VREFN_0), U1.N12 (VP_0), U1.P11 (VN_0), U1.P12 (VREFP_0), U1.R11 (DXN_0), U1.R12 (DXP_0)
GTX_125_C_N: C130.1, U4.5 (OUT-)
GTX_125_C_P: C131.1, U4.4 (OUT+)
GTX_125_N: C130.2, U1.K5 (MGTREFCLK1N_115)
GTX_125_P: C131.2, U1.K6 (MGTREFCLK1P_115)
INIT: R3.1, U1.G7 (INIT_B_0)
LED0: D7.2 (A), U1.AE25 (IO_L23N_T3_12)
LED1: D8.2 (A), U1.AF25 (IO_L20N_T3_12)
LED2: D9.2 (A), U1.AD24 (IO_L16N_T2_12)
LED3: D10.2 (A), U1.AF24 (IO_L20P_T3_12)
LED4: D11.2 (A), U1.AE23 (IO_L22P_T3_12)
LED5: D12.2 (A), U1.AF23 (IO_L22N_T3_12)
LED6: D13.2 (A), U1.AE22 (IO_L24P_T3_12)
LED7: D14.2 (A), U1.AF22 (IO_L24N_T3_12)
MGTAVCC: C12.1, C21.1, NT6.2, U1.C6 (MGTAVCC), U1.E6 (MGTAVCC), U1.G6 (MGTAVCC), U1.J6 (MGTAVCC), U1.L6 (MGTAVCC), U8.1 (VOUT3), U8.32 (VOUT3)
MGTAVTT: C15.1, C25.1, NT7.2, R1.1, U1.B3 (MGTAVTT), U1.C2 (MGTAVTT), U1.D3 (MGTAVTT), U1.G2 (MGTAVTT), U1.H3 (MGTAVTT), U1.L2 (MGTAVTT), U1.M3 (MGTAVTT), U1.M5 (MGTAVTTRCAL_115), U8.22 (VOUT4), U8.23 (VOUT4)
MPM_PG: Q1.1 (G), R23.1, R24.2, U8.26 (GPIO)
MPM_SCK: J6.1, U8.4 (SCL)
MPM_SDA: J6.2, U8.3 (SDA)
unnamed: C1.1, U8.25 (VCC)
unnamed: C3.2, U9.24 (TRK/REF)
unnamed: C17.1, U9.13 (VCC)
unnamed: C61.1, C62.1, R18.2, R19.1, U2.E2 (VREF)
unnamed: D1.1 (K), R20.1
unnamed: D2.1 (K), R21.1
unnamed: D3.1 (K), R22.1
unnamed: D6.1 (K), R25.1
unnamed: D7.1 (K), R26.1
unnamed: D8.1 (K), R27.1
unnamed: D9.1 (K), R28.1
unnamed: D10.1 (K), R29.1
unnamed: D11.1 (K), R30.1
unnamed: D12.1 (K), R31.1
unnamed: D13.1 (K), R32.1
unnamed: D14.1 (K), R33.1
unnamed: J1.A1 (~PRSNT1), J1.B48 (~PRSNT2)
unnamed: NT3.1, U8.18 (FB1)
unnamed: NT4.1, U8.6 (FB2)
unnamed: NT5.1, U8.17 (SGND1)
unnamed: NT6.1, U8.31 (FB3)
unnamed: NT7.1, U8.24 (FB4)
unnamed: NT8.1, U8.30 (SGND2)
unnamed: Q1.3 (D), R20.2
unnamed: Q2.3 (D), R21.2
unnamed: Q3.3 (D), R22.2
unnamed: R1.2, U1.M6 (MGTRREF_115)
unnamed: R5.2, U1.B25 (IO_L3P_T0_DQS_PUDC_B_14)
unnamed: R17.1, U9.22 (CS)
PCIE_RX0_N: J1.B15 (PETn0), U1.B5 (MGTXRXN3_116)
PCIE_RX0_P: J1.B14 (PETp0), U1.B6 (MGTXRXP3_116)
PCIE_RX1_N: J1.B20 (PETn1), U1.C3 (MGTXRXN2_116)
PCIE_RX1_P: J1.B19 (PETp1), U1.C4 (MGTXRXP2_116)
PCIE_RX2_N: J1.B24 (PETn2), U1.E3 (MGTXRXN1_116)
PCIE_RX2_P: J1.B23 (PETp2), U1.E4 (MGTXRXP1_116)
PCIE_RX3_N: J1.B28 (PETn3), U1.G3 (MGTXRXN0_116)
PCIE_RX3_P: J1.B27 (PETp3), U1.G4 (MGTXRXP0_116)
PCIE_RX4_N: J1.B34 (PETn4), U1.J3 (MGTXRXN3_115)
PCIE_RX4_P: J1.B33 (PETp4), U1.J4 (MGTXRXP3_115)
PCIE_RX5_N: J1.B38 (PETn5), U1.L3 (MGTXRXN2_115)
PCIE_RX5_P: J1.B37 (PETp5), U1.L4 (MGTXRXP2_115)
PCIE_RX6_N: J1.B42 (PETn6), U1.N3 (MGTXRXN1_115)
PCIE_RX6_P: J1.B41 (PETp6), U1.N4 (MGTXRXP1_115)
PCIE_RX7_N: J1.B46 (PETn7), U1.R3 (MGTXRXN0_115)
PCIE_RX7_P: J1.B45 (PETp7), U1.R4 (MGTXRXP0_115)
PCIE_SCK: J1.B5 (SMCLK), J6.3
PCIE_SDA: J1.B6 (SMDAT), J6.4
PCIE_TX0_C_N: C101.1, J1.A17 (PERn0)
PCIE_TX0_C_P: C100.1, J1.A16 (PERp0)
PCIE_TX0_N: C101.2, U1.A3 (MGTXTXN3_116)
PCIE_TX0_P: C100.2, U1.A4 (MGTXTXP3_116)
PCIE_TX1_C_N: C103.1, J1.A22 (PERn1)
PCIE_TX1_C_P: C102.1, J1.A21 (PERp1)
PCIE_TX1_N: C103.2, U1.B1 (MGTXTXN2_116)
PCIE_TX1_P: C102.2, U1.B2 (MGTXTXP2_116)
PCIE_TX2_C_N: C105.1, J1.A26 (PERn2)
PCIE_TX2_C_P: C104.1, J1.A25 (PERp2)
PCIE_TX2_N: C105.2, U1.D1 (MGTXTXN1_116)
PCIE_TX2_P: C104.2, U1.D2 (MGTXTXP1_116)
PCIE_TX3_C_N: C107.1, J1.A30 (PERn3)
PCIE_TX3_C_P: C106.1, J1.A29 (PERp3)
PCIE_TX3_N: C107.2, U1.F1 (MGTXTXN0_116)
PCIE_TX3_P: C106.2, U1.F2 (MGTXTXP0_116)
PCIE_TX4_C_N: C109.1, J1.A36 (PERn4)
PCIE_TX4_C_P: C108.1, J1.A35 (PERp4)
PCIE_TX4_N: C109.2, U1.H1 (MGTXTXN3_115)
PCIE_TX4_P: C108.2, U1.H2 (MGTXTXP3_115)
PCIE_TX5_C_N: C111.1, J1.A40 (PERn5)
PCIE_TX5_C_P: C110.1, J1.A39 (PERp5)
PCIE_TX5_N: C111.2, U1.K1 (MGTXTXN2_115)
PCIE_TX5_P: C110.2, U1.K2 (MGTXTXP2_115)
PCIE_TX6_C_N: C113.1, J1.A44 (PERn6)
PCIE_TX6_C_P: C112.1, J1.A43 (PERp6)
PCIE_TX6_N: C113.2, U1.M1 (MGTXTXN1_115)
PCIE_TX6_P: C112.2, U1.M2 (MGTXTXP1_115)
PCIE_TX7_C_N: C115.1, J1.A48 (PERn7)
PCIE_TX7_C_P: C114.1, J1.A47 (PERp7)
PCIE_TX7_N: C115.2, U1.P1 (MGTXTXN0_115)
PCIE_TX7_P: C114.2, U1.P2 (MGTXTXP0_115)
PERST: J1.A11 (~PERST), J7.2, Q3.1 (G)
PROGRAM: R4.1, U1.P6 (PROGRAM_B_0)
REFCLK_C_N: C121.2, J1.A14 (REFCLK-)
REFCLK_C_P: C120.2, J1.A13 (REFCLK+)
REFCLK_N: C121.1, U1.D5 (MGTREFCLK0N_116)
REFCLK_P: C120.1, U1.D6 (MGTREFCLK0P_116)
SPI_CLK: U1.C8 (CCLK_0), U3.6 (CLK)
SPI_CS: R6.2, U1.C23 (IO_L6P_T0_FCS_B_14), U3.1 (~CS)
SPI_D0: U1.B24 (IO_L1P_T0_D00_MOSI_14), U3.5 (DI(IO0))
SPI_D1: U1.A25 (IO_L1N_T0_D01_DIN_14), U3.2 (DO(IO1))
SPI_D2: R7.2, U1.B22 (IO_L2P_T0_D02_14), U3.3 (IO2)
SPI_D3: R8.2, U1.A22 (IO_L2N_T0_D03_14), U3.7 (IO3)
SW: U9.14 (SW), U9.16 (SW), U9.19 (SW), U9.28 (SW)
TCK: JP2.2, U1.L8 (TCK_0)
TDI: JP2.5, U1.R6 (TDI_0)
TDO: JP2.4, U1.R7 (TDO_0)
TMS: JP2.3, U1.N8 (TMS_0)
UART_RX: J5.2, R10.2, U1.G26 (IO_L16N_T2_A15_D31_14)
UART_TX: J5.1, R9.2, U1.H26 (IO_L18N_T2_A11_D27_14)
VDDA: C18.2, C19.1, FB2.1, U1.M12 (VCCADC_0)
VSENSE_N: NT1.2, R12.2, U9.25 (VO_SENSE_N)
VSENSE_P: C2.1, NT2.1, R11.1

Notes on the sheet:
3.3V@3A
LVDS
1.2V@2A
UNUSED
1.8V@3A
1V@2A
GTX/PCIe
LEDS
CONFIG & DEBUG
DDR2
1V@8A
POWER
